brunnerj/CKT-1000/PTI.brd

## EAGLE design PTI.brd (2019-11-04)

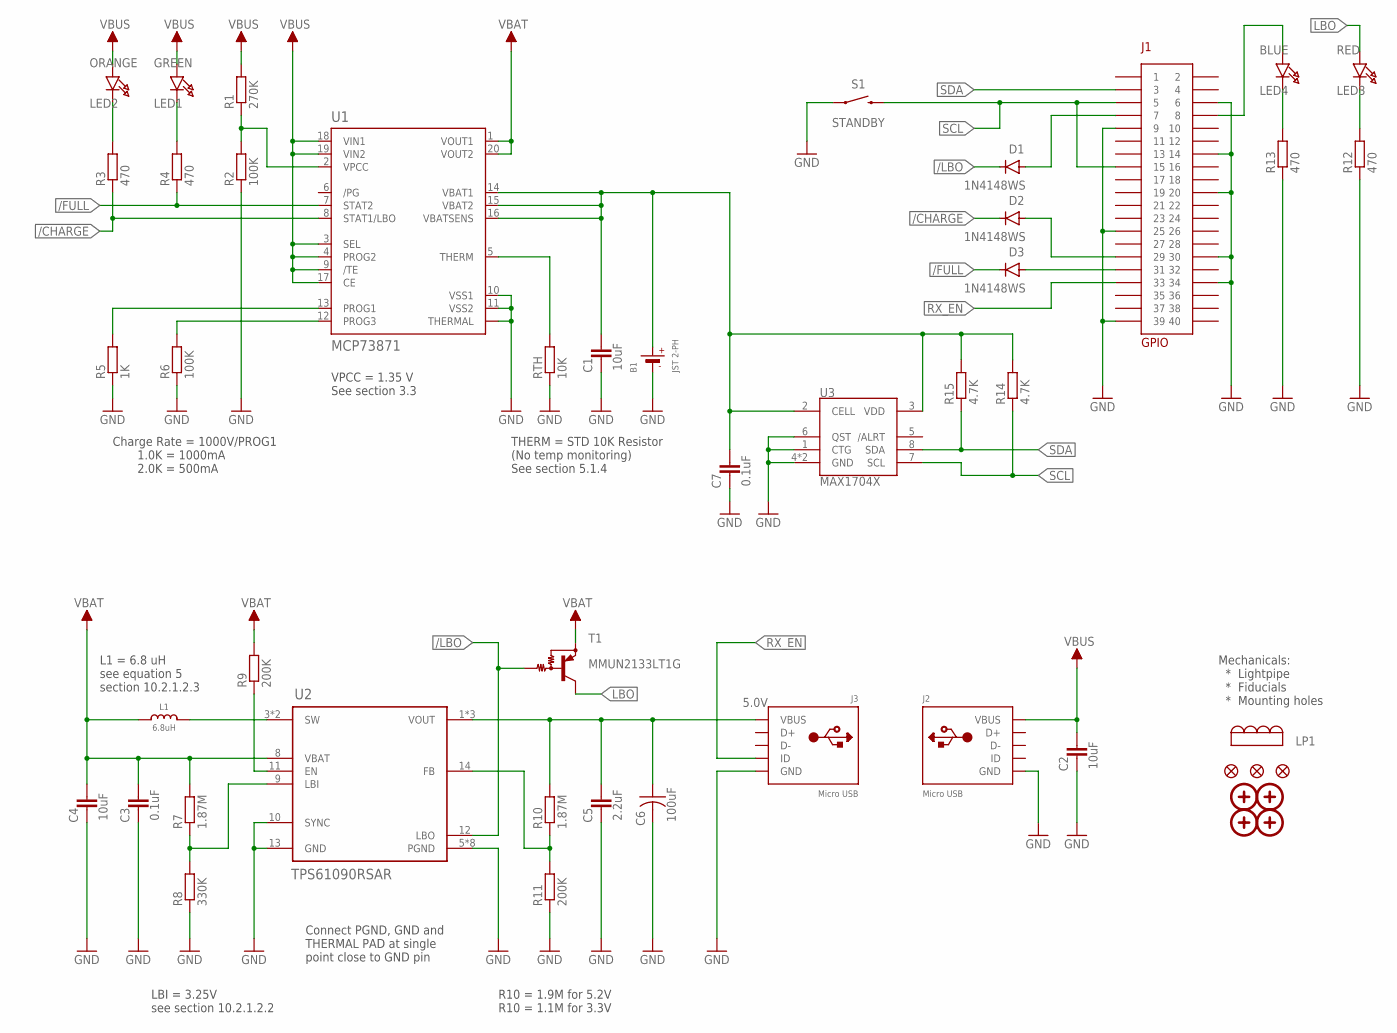
[picture p1: schematic PTI.sch]

Parts:
B1: JST 2-PH; JSTPH2
C1, C2, C4: 10uF; C0805
C3, C7: 0.1uF; C0805
C5: 2.2uF; C0805
C6: 100uF; C1210
D1, D2, D3: 1N4148WS; SOD-323
FID1, FID2, FID3: FIDUCIAL""; FIDUCIAL_1MM
J1: GPIO; HEADER-FE-2X20-TH
J2, J3: Micro USB; AMPHENOL_10103594
L1: 6.8uH; INDUCTOR_5X5MM_TDK_VLC5045
LED1: GREEN; CHIPLED_0805_NOOUTLINE
LED2: ORANGE; CHIPLED_0805_NOOUTLINE
LED3: RED; CHIPLED_0805_NOOUTLINE
LED4: BLUE; CHIPLED_0805_NOOUTLINE
LP1: LIGHTPIPE; LIGHTPIPE_QUAD_VERT_3MM
MH1, MH2, MH3, MH4: MOUNTING-HOLES; MOUNTING-HOLE-2.75X3MM
R1: 270K; R0805
R2, R6: 100K; R0805
R3, R4, R12, R13: 470; R0805
R5: 1K; R0805
R7, R10: 1.87M; R0805
R8: 330K; R0805
R9, R11: 200K; R0805
R14, R15: 4.7K; R0805
RTH: 10K; R0805
S1: STANDBY; TACTILE_SWITCH_PTH_12MM
T1: MMUN2133LT1G; SC59-BEC
U1: MCP73871; QFN20_4MM
U2: TPS61090RSAR; RSA16_4MMX4MM_VQFN
U3: MAX1704X; TDFN-8

Connections:
5.0V: C5.1, C6.1, J3.VBUS, R10.2, U2.1 (VOUT), U2.15 (VOUT), U2.16 (VOUT)
/CHARGE: D2.C, R3.1, U1.8 (STAT1/LBO)
/FULL: D3.C, R4.1, U1.7 (STAT2)
/LBO: D1.C, T1.B, U2.12 (LBO)
GND: B1.1 (-), B1.NC1 (-), B1.NC2 (-), C1.2, C2.2, C3.2, C4.2, C5.2, C6.2, C7.2, J1.P$6 (6), J1.P$9 (9), J1.P$14 (14), J1.P$20 (20), J1.P$25 (25), J1.P$30 (30), J1.P$34 (34), J1.P$39 (39), J2.BASE@1 (GND), J2.BASE@2 (GND), J2.GND, J2.SPRT@1 (GND), J2.SPRT@2 (GND), J2.SPRT@3 (GND), J2.SPRT@4 (GND), J3.BASE@1 (GND), J3.BASE@2 (GND), J3.GND, J3.SPRT@1 (GND), J3.SPRT@2 (GND), J3.SPRT@3 (GND), J3.SPRT@4 (GND), R2.1, R5.1, R6.1, R8.1, R11.1, R12.1, R13.1, RTH.1, S1.1, U1.10 (VSS1), U1.11 (VSS2), U1.P$21 (THERMAL), U1.P$22 (THERMAL), U1.P$23 (THERMAL), U1.P$24 (THERMAL), U2.5 (PGND), U2.6 (PGND), U2.7 (PGND), U2.10 (SYNC), U2.13 (GND), U2.P$17 (PGND), U2.P$18 (PGND), U2.P$19 (PGND), U2.P$20 (PGND), U2.P$21 (PGND), U3.1 (CTG), U3.4 (GND), U3.6 (QST), U3.EP (GND)
LBO: LED3.A, T1.C
unnamed: RTH.2, U1.5 (THERM)
unnamed: R1.1, R2.2, U1.2 (VPCC)
unnamed: D1.A, J1.P$7 (7)
unnamed: D2.A, J1.P$29 (29)
unnamed: R5.2, U1.13 (PROG1)
unnamed: R6.2, U1.12 (PROG3)
unnamed: LED2.C, R3.2
unnamed: LED1.C, R4.2
unnamed: B1.2 (+), C1.1, C7.1, R14.2, R15.2, U1.14 (VBAT1), U1.15 (VBAT2), U1.16 (VBATSENS), U3.2 (CELL), U3.3 (VDD)
unnamed: L1.P$2 (2), U2.3 (SW), U2.4 (SW)
unnamed: R7.1, R8.2, U2.9 (LBI)
unnamed: R9.1, U2.11 (EN)
unnamed: R10.1, R11.2, U2.14 (FB)
unnamed: LED3.C, R12.2
unnamed: D3.A, J1.P$31 (31)
unnamed: LED4.C, R13.2
RX_EN: J1.P$33 (33), J3.ID
SCL: J1.P$5 (5), J1.P$15 (15), R14.1, S1.3 (2), U3.7 (SCL)
SDA: J1.P$3 (3), R15.1, U3.8 (SDA)
STATUS: J1.P$8 (8), LED4.A
VBAT: C3.1, C4.1, L1.P$1 (1), R7.2, R9.2, T1.E, U1.1 (VOUT1), U1.20 (VOUT2), U2.8 (VBAT)
VBUS: C2.1, J2.VBUS, LED1.A, LED2.A, R1.2, U1.3 (SEL), U1.4 (PROG2), U1.9 (/TE), U1.17 (CE), U1.18 (VIN1), U1.19 (VIN2)

Notes on the sheet:
Charge Rate = 1000V/PROG1 1.0K = 1000mA 2.0K = 500mA
THERM = STD 10K Resistor (No temp monitoring) See section 5.1.4
VPCC = 1.35 V See section 3.3
Connect PGND, GND and THERMAL PAD at single point close to GND pin
R10 = 1.9M for 5.2V R10 = 1.1M for 3.3V
LBI = 3.25V see section 10.2.1.2.2
L1 = 6.8 uH see equation 5 section 10.2.1.2.3
Mechanicals: * Lightpipe * Fiducials * Mounting holes

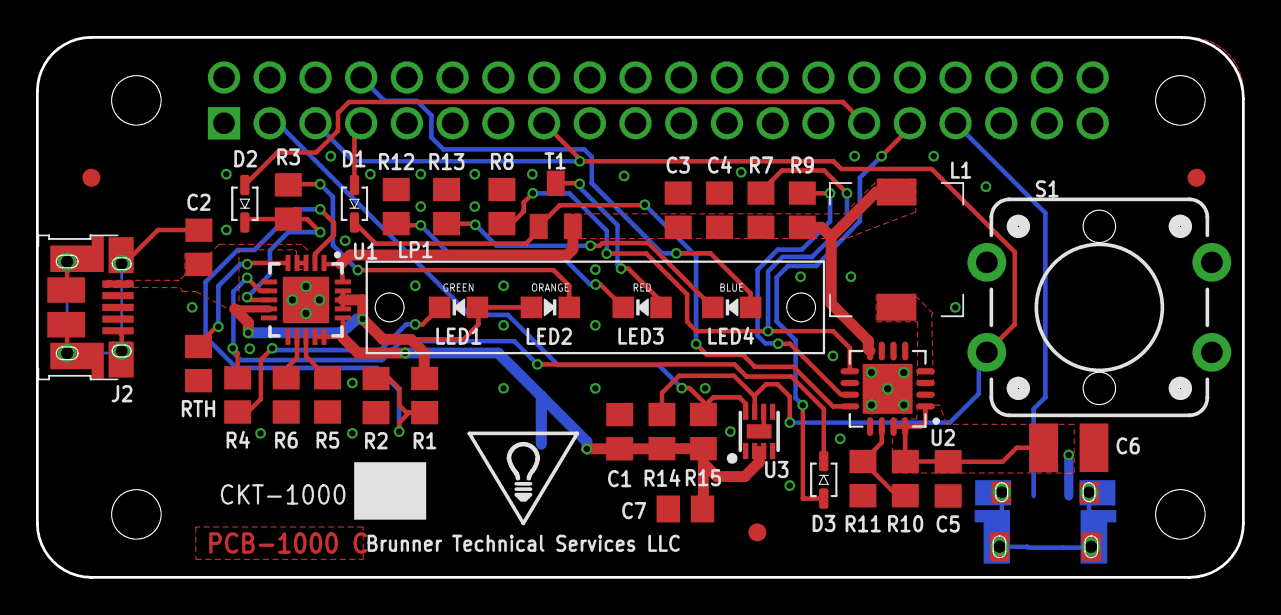
[picture p2: board PTI.brd from above]

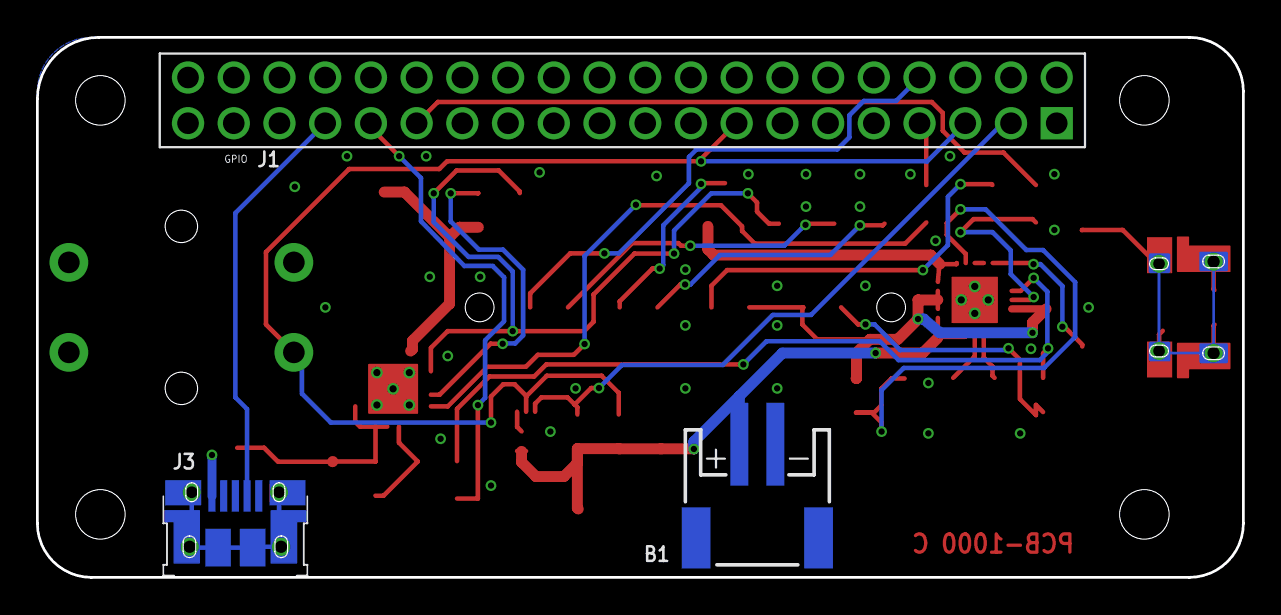
[picture p3: board PTI.brd from below]

Board: 2 copper layers, 67.0 x 30.0 mm, 48 parts (3 on the bottom side), 28 nets.
