brunnerj/CKT-1000/(commit log)

2019-08-28 initial commit - rev A
    [PTI.brd, PTI.sch]
2019-08-30 Rev B adds 2mm to the left side of the board to facilitate USB connections.
    [PTI.brd, PTI.sch]
2019-11-04 Routes GPIO13 (pin 33 on J1) to the ID pin on J3 (power out to USB manifold). This GPIO can be used to toggle on/off a MOSFET on the USB manifold used to enable or disable receiver 5V power bus.
    [PTI.brd, PTI.sch]
